maskeynihal/sensor-for-cars/docs/howto/README.md

# How-to guides

| Guide | When |
|---|---|
| [setup-toolchain](setup-toolchain.md) | Fresh Mac / new clone |
| [run-native-tests](run-native-tests.md) | Every change: fast host tests |
| [run-wokwi-sim](run-wokwi-sim.md) | Before promote: full circuit sim |
| [promote-sim-to-firmware](promote-sim-to-firmware.md) | Sim copy is green, move it to firmware |
| [build-and-upload](build-and-upload.md) | Flash the real board |
| [new-project](new-project.md) | Start a new board/project |
| [add-a-library](add-a-library.md) | A sketch needs a new Arduino library |
| [troubleshooting](troubleshooting.md) | Something broke |
