maskeynihal/sensor-for-cars/docs/ideas/README.md

# Ideas

Things worth building that aren't committed to yet. One file per idea:
`YYYY-MM-DD-kebab-title.md`, from [_template.md](_template.md). New idea: `/idea <title>`.

When an idea becomes a project (`make new ...`), set its status to `Building -> projects/<name>` and link it from the
project README. Decisions that come out of an idea go in [`../adr/`](../adr/).

| Date | Idea | Status |
|---|---|---|
| 2026-11-01 | [Water + air temperature monitor](2026-11-01-water-monitor.md) | Building -> projects/water_monitor |
| 2026-11-01 | [HJ60 coolant temperature from the OEM sender](2026-11-01-hj60-coolant.md) | Building -> projects/hj60_coolant |
