maskeynihal/sensor-for-cars/templates/project/docs/README.md

# __NAME__ -- hardware

> Fill in as the build takes shape. The agent keeps this in step with
> `emulator/wokwi/diagram.json`.

## Bill of materials

| Qty | Part | Notes |
|---|---|---|
| 1 | __BOARD__ | |

## Wiring

| Part pin | Board pin | Notes |
|---|---|---|
| | | |

## Power

TBD

## Sim vs real differences

| Real hardware | Emulator | Why |
|---|---|---|
| __BOARD__ | __SIM_BOARD__ | |
