maskeynihal/sensor-for-cars/projects/_archive/README.md

# Archive

Superseded sketches kept for reference. Don't build on them.

| Sketch | Superseded by |
|---|---|
| `lc78_oled_animation/` | OLED-only LC78 animation, no sensors → `projects/water_monitor` |
