maskeynihal/sensor-for-cars/projects/hj60_coolant/docs/img/design-boot-title.png

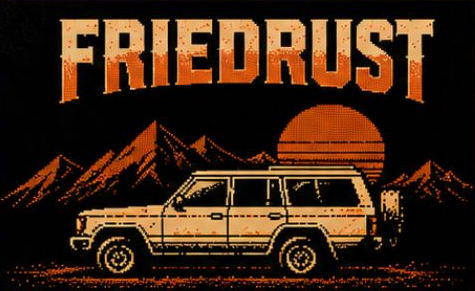
projects/hj60_coolant/docs/img/design-boot-title.png
