maskeynihal/sensor-for-cars/projects/hj60_coolant/docs/img/design-boot-truck.png

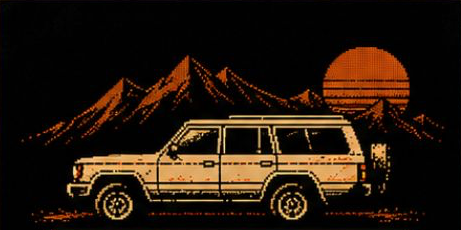
projects/hj60_coolant/docs/img/design-boot-truck.png
