maskeynihal/sensor-for-cars/projects/hj60_coolant/docs/img/wiring-diagram.png

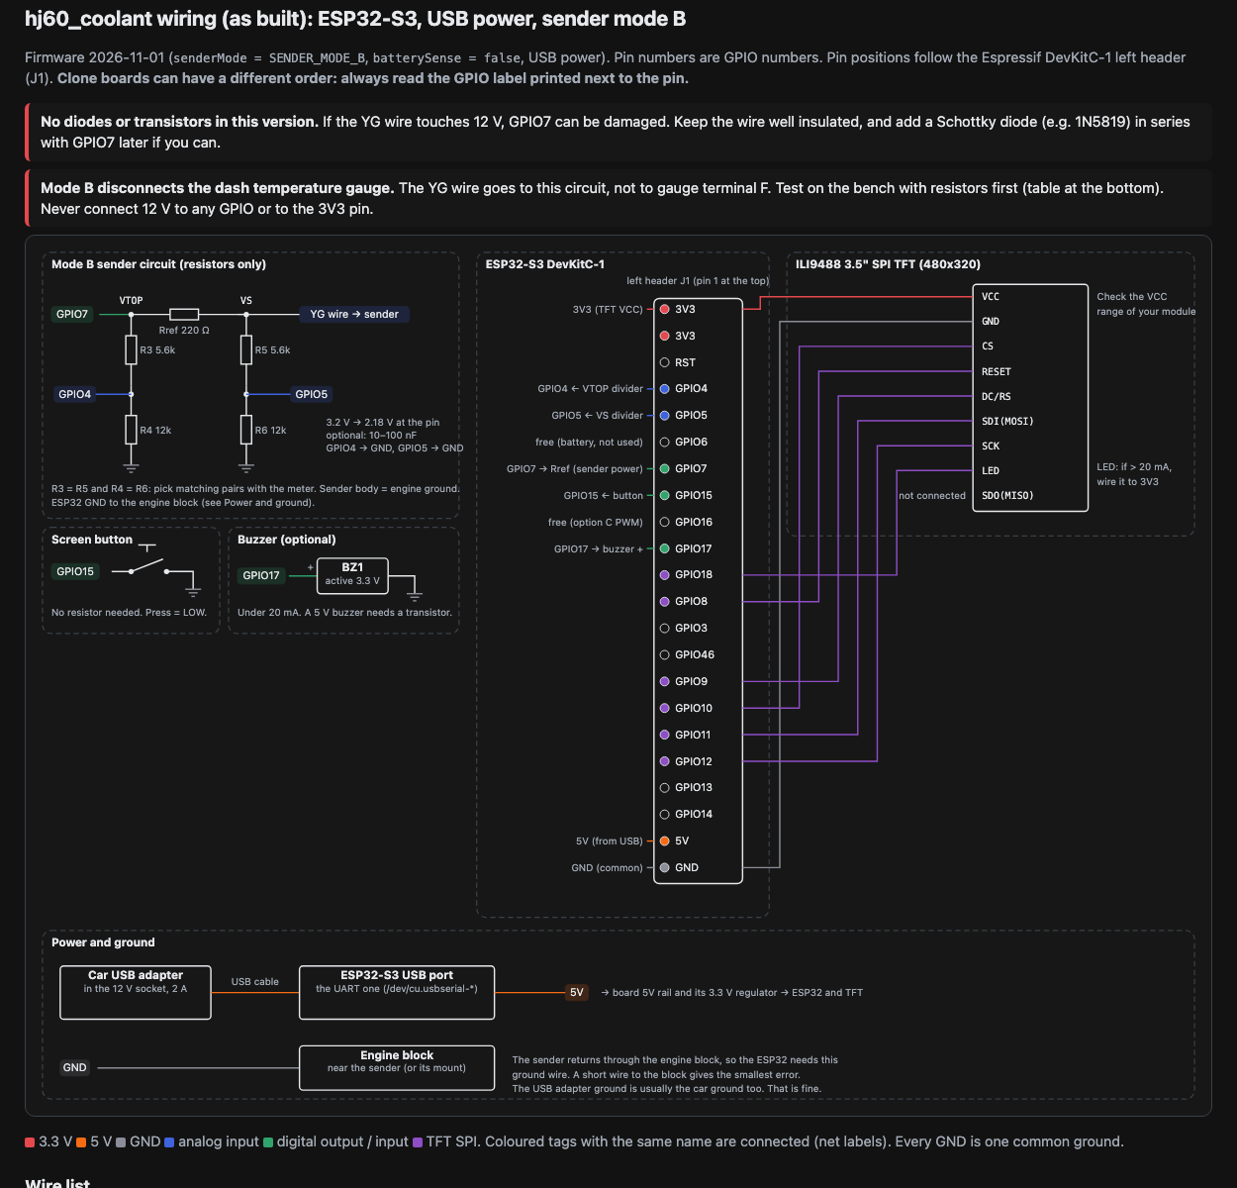
projects/hj60_coolant/docs/img/wiring-diagram.png
