maskeynihal/sensor-for-cars/tools/native/mocks/Wire.h

#pragma once
#include "Arduino.h"

class TwoWire {
public:
  void begin() {}
  void setClock(uint32_t) {}
  void beginTransmission(uint8_t addr) { txAddr_ = addr; }
  uint8_t endTransmission(bool stop = true);
  size_t write(uint8_t) { return 1; }
  size_t write(const uint8_t *, size_t n) { return n; }
  uint8_t requestFrom(uint8_t, uint8_t) { return 0; }
  int available() { return 0; }
  int read() { return -1; }

private:
  uint8_t txAddr_ = 0;
};

extern TwoWire Wire;
