maskeynihal/sensor-for-cars/(commit log)

2026-10-26 Reorganize sketches, add docs (markdown + interactive HTML), sensor explainer (#1)
    * Reorganize sketches, add final water_monitor build + docs
    - Move all sketches under sketches/
    - Rename ssd1306_128x32_i2c -> lc78_oled_animation (SH1106 128x64 OLED animation, no sensors)
    - Add final build sketches/water_monitor (DS18B20 + DHT22 + active buzzer, 3 states)
    - Add docs/README.md (BOM, circuit diagram, buzzer logic, arduino-cli build/upload, bring-up, troubleshooting)
    - Add root README.md with folder map and CLI build steps
    - Remove dead sketches (graphicstest, graphicstest_copy, empty i2_address_finder.ino)
    - Ignore local .kiro/ tooling config
    * Split docs into markdown/ and html/, add intera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
2026-10-26 Fix HTML hash nav: resolve any id to its pane, defer scroll, clickable headings (#4)
    - paneOf() walks up to .tabpane so explainer sub-links (#s-ds, #s-physics...)
    switch to the Explainer tab instead of defaulting to How-to (the core bug)
    - Scroll deferred to next frame after the pane is shown (display:none race)
    - Manual scroll with sticky-nav offset; scrollspy uses viewport rects + suppress
    guard during programmatic scroll
    - Section h3 and explainer h4 headings are now clickable to set the URL hash
    - Verified with a jsdom harness: 85/85 nav/heading/hashchange checks pass
2026-11-01 HJ60 coolant monitor (ESP32-S3 + TFT), repo tooling, merge with main (#5)
    Squash of the hj60-coolant branch: agent-driven hardware workflow and tooling, water_monitor under projects/, new hj60_coolant (ESP32-S3, ILI9488 TFT dashboard, sender mode A/B), docs and ADRs, merged with the old-layout docs PRs #1-#4.
